guillediaaazz/FDEM_transmitter/Hardware/3d_models/ESP32-DEVKITC-32U.step

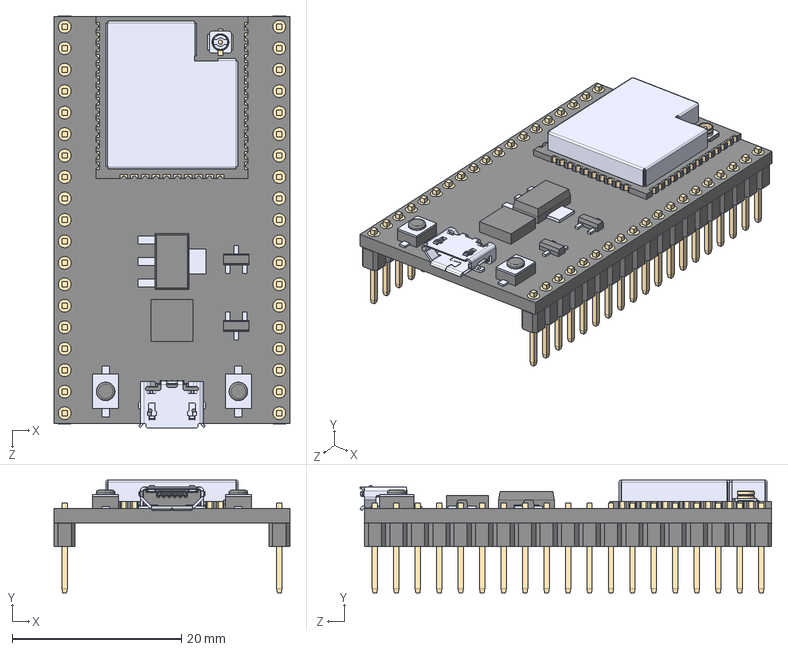
[picture p1: CAD file, 2026-08-08]
Hardware/3d_models/ESP32-DEVKITC-32U.step
27.9 x 13.4 x 48.8 mm
