guillediaaazz/FDEM_transmitter/Hardware/FDEM_tx_schematic.pdf

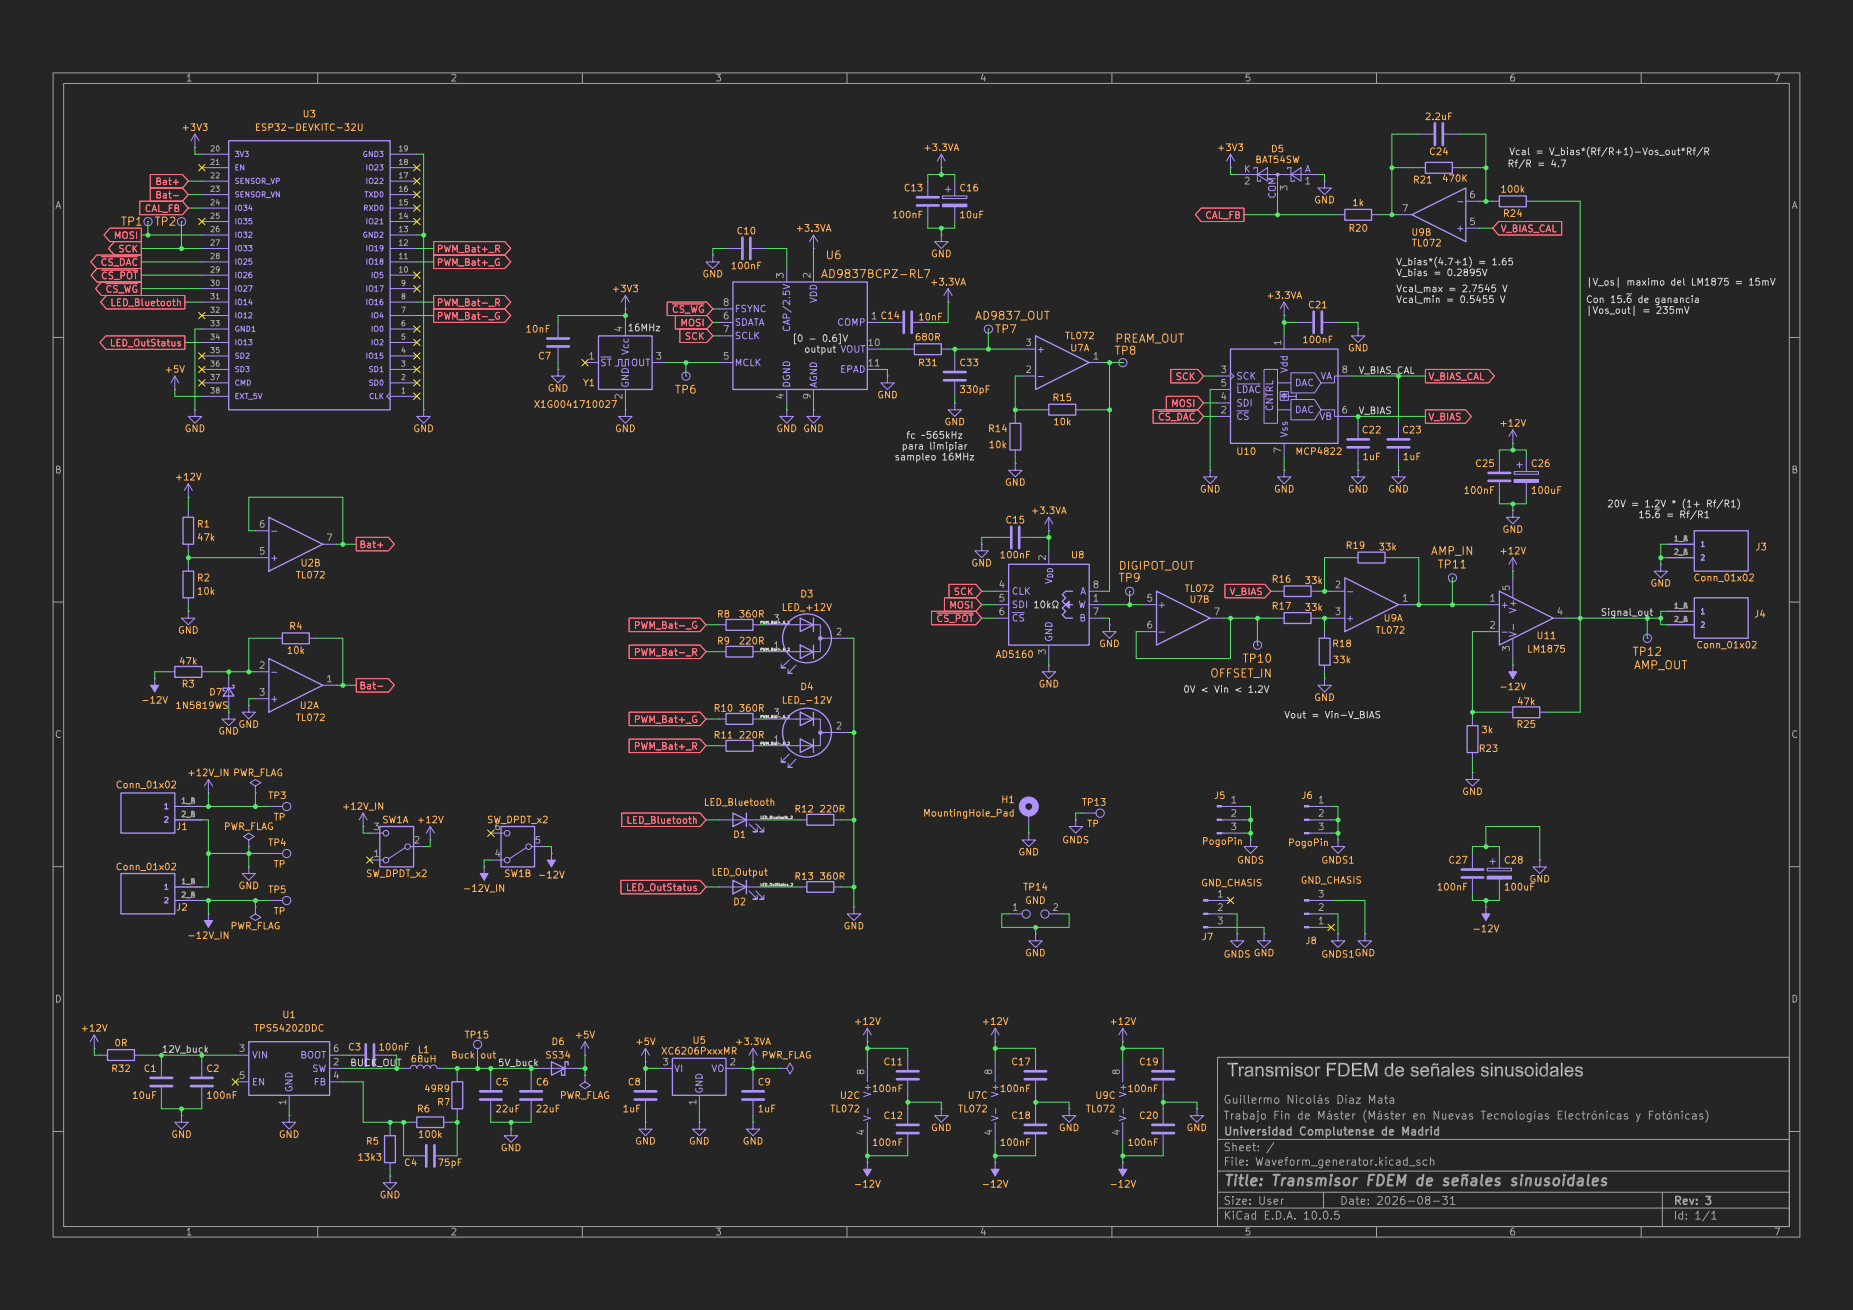
[picture p2: page 1]
