guillediaaazz/FDEM_transmitter/Hardware/FDEM_tx_schematic_rotated.pdf

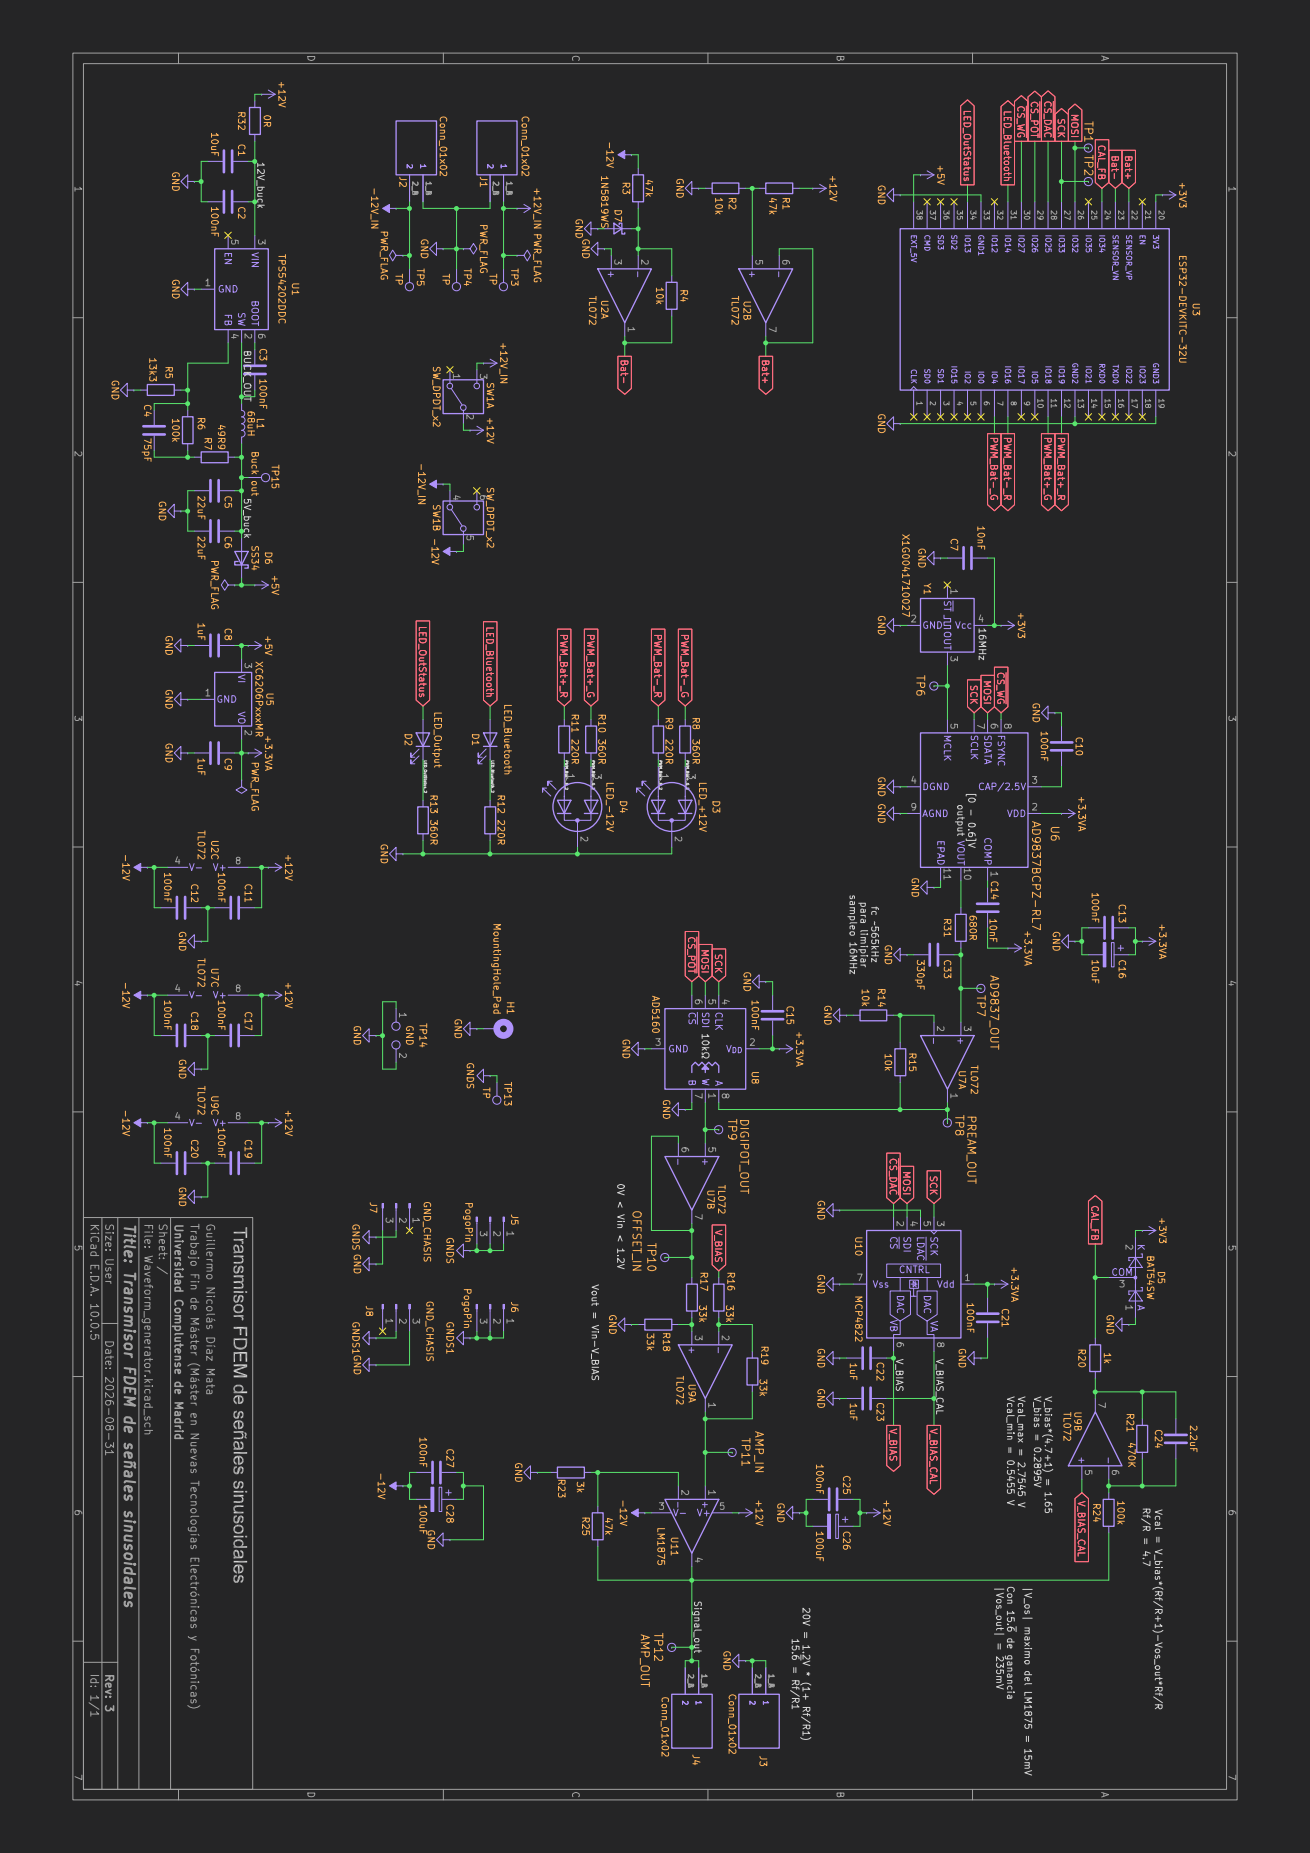
[picture p3: page 1]
