guillediaaazz/FDEM_transmitter/Hardware/FDEM_tx_schematic_rev3.pdf

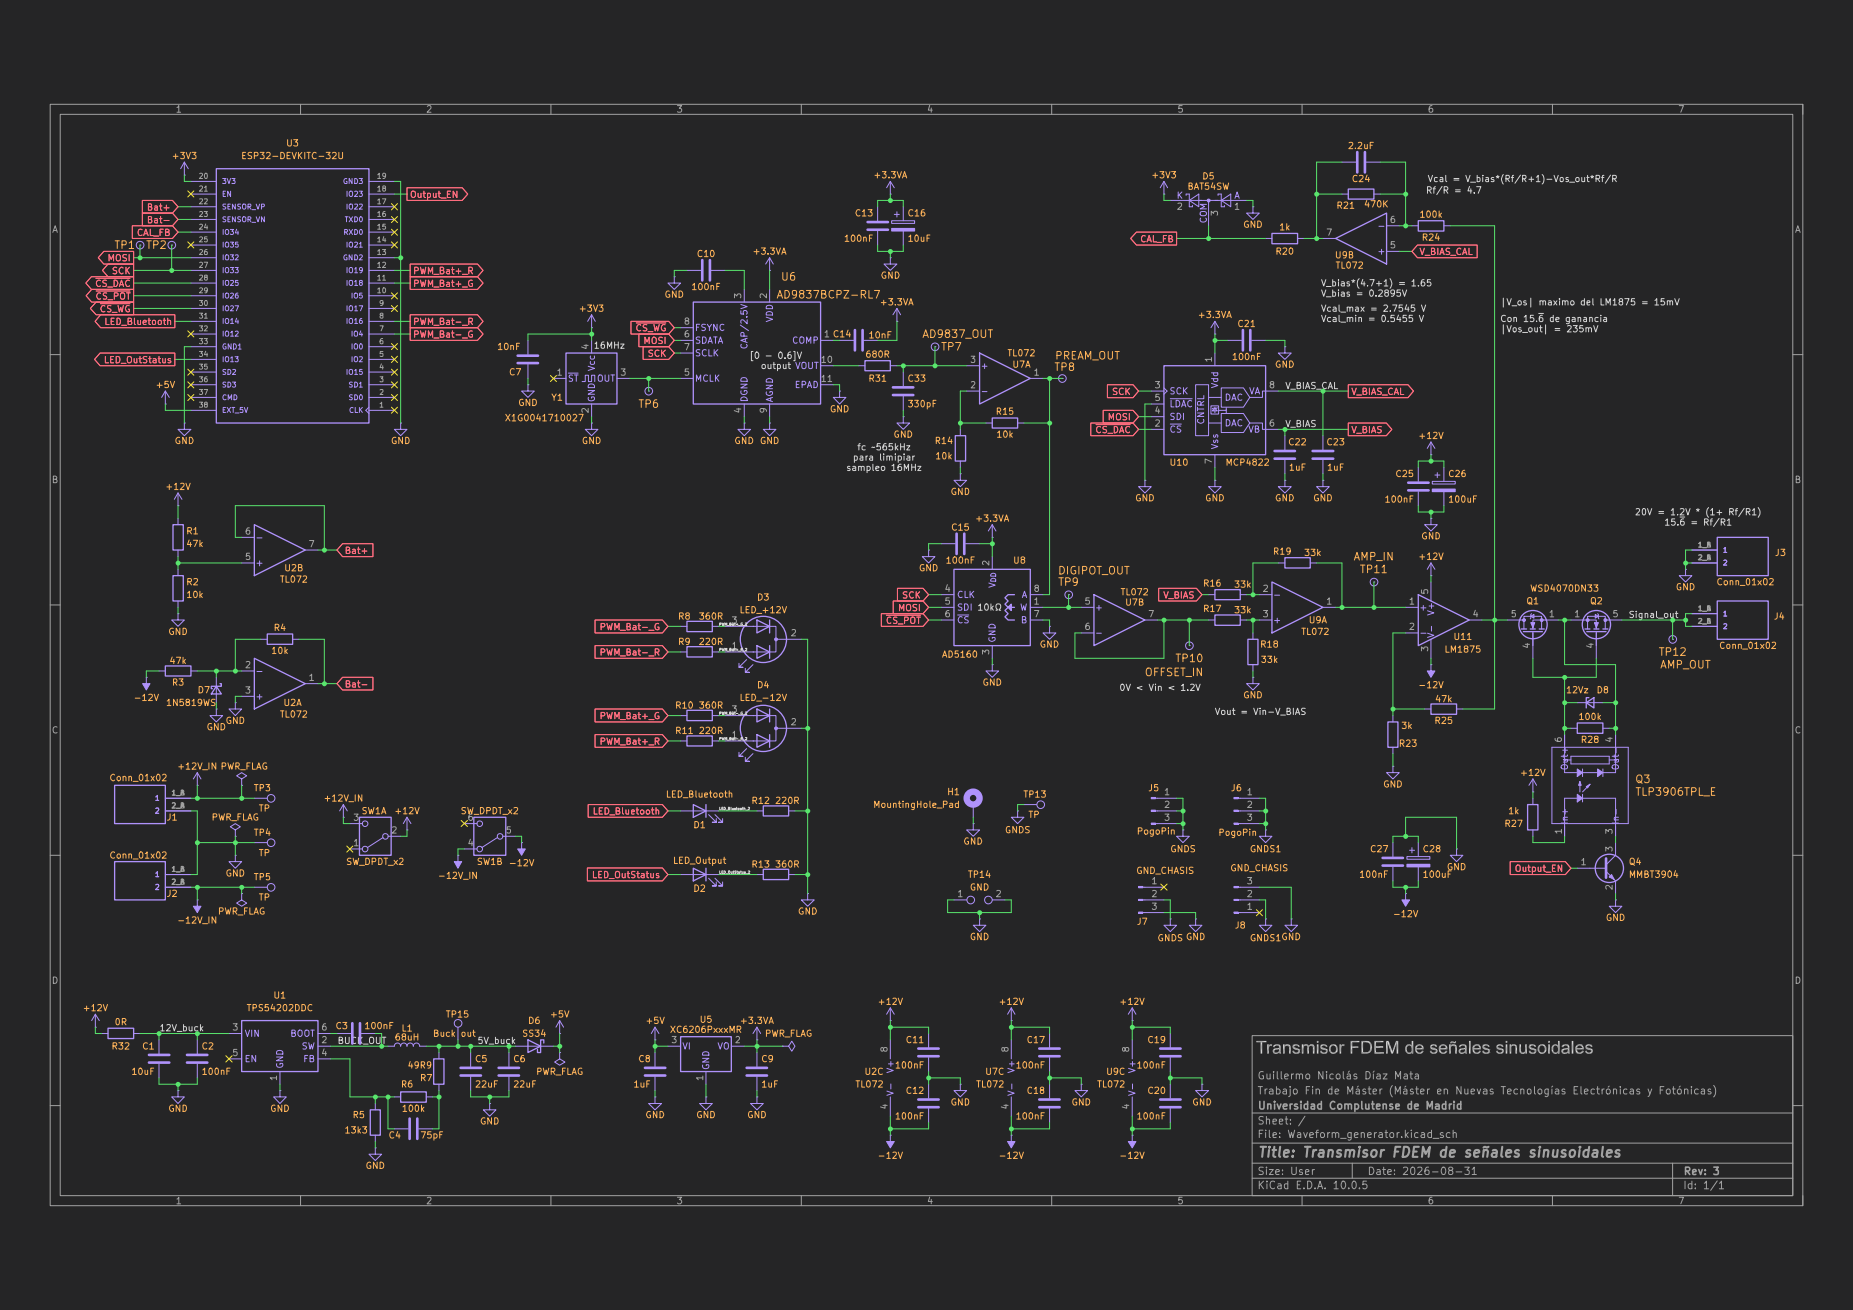
[picture p4: page 1]
