guillediaaazz/FDEM_transmitter/Hardware/Waveform_generator/Waveform_generator.kicad_pcb

## KiCad design Hardware/Waveform_generator/Waveform_generator.kicad_pcb (2026-09-06)

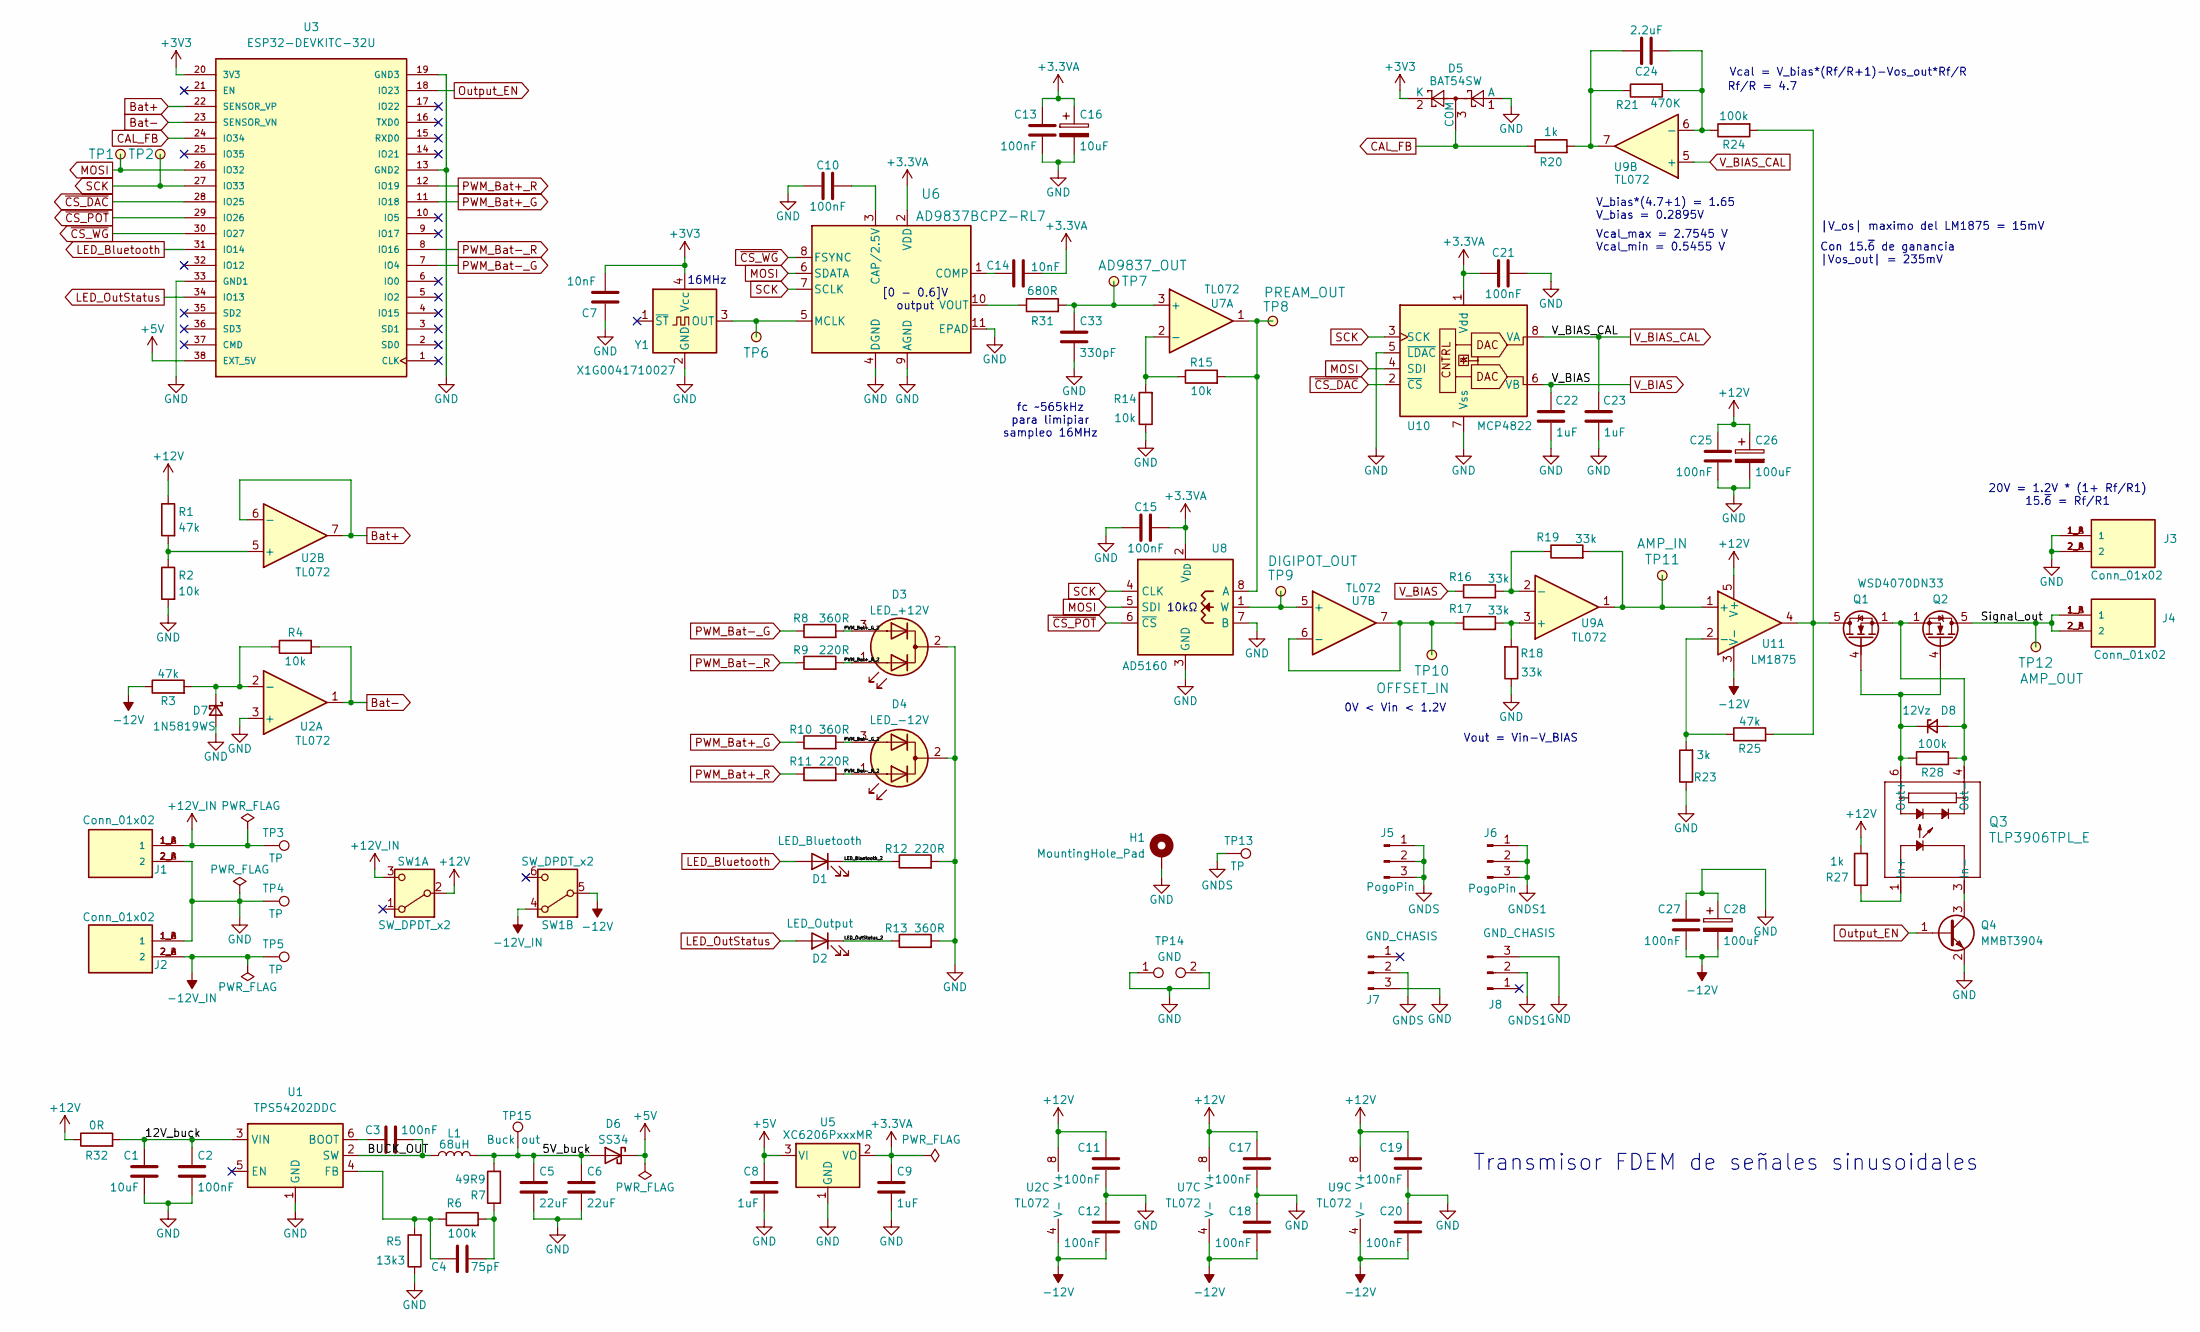
[picture p5: schematic Waveform_generator.kicad_sch, Transmisor FDEM de señales sinusoidales]

Parts:
C1: 10uF; C_0805_2012Metric_Pad1.18x1.45mm_HandSolder; LCSC C15850
C2, C3, C10, C11, C12, C13, C15, C17, C18, C19, C20, C21, C25, C27: 100nF; C_0603_1608Metric_Pad1.08x0.95mm_HandSolder; LCSC C14663
C4: 75pF; C_0402_1005Metric_Pad0.74x0.62mm_HandSolder; LCSC C107010
C5, C6: 22uF; C_0603_1608Metric_Pad1.08x0.95mm_HandSolder; LCSC C59461
C7, C14: 10nF; C_0402_1005Metric_Pad0.74x0.62mm_HandSolder; LCSC C15195
C8, C9: 1uF; C_0603_1608Metric_Pad1.08x0.95mm_HandSolder; LCSC C15849
C16: 10uF; CP_EIA-3216-18_Kemet-A_HandSolder; LCSC C7171
C22, C23: 1uF; C_0805_2012Metric_Pad1.18x1.45mm_HandSolder; LCSC C1712
C24: 2.2uF; C_0603_1608Metric_Pad1.08x0.95mm_HandSolder; LCSC C23630
C26, C28: 100uF; CP_Radial_D5.0mm_P2.00mm
C33: 330pF; C_0603_1608Metric_Pad1.08x0.95mm_HandSolder; LCSC C1664
D1: LED_Bluetooth; LED_D3.0mm_Horizontal_O1.27mm_Z2.0mm
D2: LED_Output; LED_D3.0mm_Horizontal_O1.27mm_Z2.0mm
D3: LED_+12V; LED_D3.0mm-3
D4: LED_-12V; LED_D3.0mm-3
D5: BAT54SW; SOT-323_SC-70; LCSC C22466373
D6: SS34; D_SMA; LCSC C8678
D7: 1N5819WS; D_SOD-323_HandSoldering; LCSC C191023
D8: 12Vz; D_SOD-323; LCSC C19077447
H1: MountingHole_Pad; MountingHole_3.2mm_M3_Pad_TopBottom
J1, J2, J3, J4: Conn_01x02; KF142R_2p
J5, J6: PogoPin; Pogo pin 1x3 2.54mm male horizontal
J7: GND_CHASIS; PinHeader_1x03_P2.54mm_Vertical
J8: GND_CHASIS; PinHeader_1x03_P2.54mm_Horizontal
L1: 68uH; L_Sunlord_SWPA6045S; LCSC C53663
Q1, Q2: WSD4070DN33; VSON-8_3.3x3.3mm_P0.65mm_NexFET; LCSC C719095
Q3: TLP3906TPL_E; 4pin SO6_TOS; LCSC C146278
Q4: MMBT3904; SOT-23; LCSC C20526
R1, R3, R25: 47k; R_0603_1608Metric_Pad0.98x0.95mm_HandSolder; LCSC C25819
R2, R4, R14, R15: 10k; R_0805_2012Metric_Pad1.20x1.40mm_HandSolder; LCSC C17414
R5: 13k3; R_0603_1608Metric_Pad0.98x0.95mm_HandSolder; LCSC C25952
R6, R24, R28: 100k; R_0603_1608Metric_Pad0.98x0.95mm_HandSolder; LCSC C25803
R7: 49R9; R_0805_2012Metric_Pad1.20x1.40mm_HandSolder; LCSC C17720
R8, R10, R13: 360R; R_0603_1608Metric_Pad0.98x0.95mm_HandSolder; LCSC C25194
R9, R11, R12: 220R; R_0805_2012Metric_Pad1.20x1.40mm_HandSolder; LCSC C17557
R16, R17, R18, R19: 33k; R_0603_1608Metric_Pad0.98x0.95mm_HandSolder; LCSC C4216
R20, R27: 1k; R_0603_1608Metric_Pad0.98x0.95mm_HandSolder; LCSC C21190
R21: 470K; R_0603_1608Metric_Pad0.98x0.95mm_HandSolder; LCSC C23178
R23: 3k; R_0603_1608Metric_Pad0.98x0.95mm_HandSolder; LCSC C4211
R31: 680R; R_0805_2012Metric_Pad1.20x1.40mm_HandSolder; LCSC C17798
R32: 0R; R_1206_3216Metric_Pad1.30x1.75mm_HandSolder; LCSC C17888
SW1: SW_DPDT_x2; SPDT_6P_MTS-2XX_C4_horizontal
TP1, TP2, TP6: Test Point; TestPoint_THTPad_D2.0mm_Drill1.0mm; Part Number HARWIN_S1751-46
TP3, TP4, TP5, TP13: TP; TestPoint_THTPad_D2.0mm_Drill1.0mm
TP7: AD9837_OUT; TestPoint_THTPad_D2.0mm_Drill1.0mm; Part Number HARWIN_S1751-46
TP8: PREAM_OUT; TestPoint_THTPad_D2.0mm_Drill1.0mm; Part Number HARWIN_S1751-46
TP9: DIGIPOT_OUT; TestPoint_THTPad_D2.0mm_Drill1.0mm; Part Number HARWIN_S1751-46
TP10: OFFSET_IN; TestPoint_THTPad_D2.0mm_Drill1.0mm; Part Number HARWIN_S1751-46
TP11: AMP_IN; TestPoint_THTPad_D2.0mm_Drill1.0mm; Part Number HARWIN_S1751-46
TP12: AMP_OUT; TestPoint_THTPad_D2.0mm_Drill1.0mm; Part Number HARWIN_S1751-46
TP14: GND; PinHeader_1x02_P2.54mm_Vertical
TP15: Buck out; TestPoint_THTPad_D2.0mm_Drill1.0mm
U1: TPS54202DDC; SOT-23-6; LCSC C191884
U2, U7, U9: TL072; SOIC-8_3.9x4.9mm_P1.27mm; LCSC C6961
U3: ESP32-DEVKITC-32U; ESP32_38pin; PARTREV V4
U5: XC6206PxxxMR; SOT-23-3; LCSC C5446
U6: AD9837BCPZ-RL7; 10-Lead LFCSP_WD (CP-10-9); LCSC C138562
U8: AD5160; SOT-23-8; LCSC C40097
U10: MCP4822; SOIC-8_3.9x4.9mm_P1.27mm; LCSC C16040
U11: LM1875; TO-220-5_P3.4x3.7mm_StaggerOdd_Lead3.8mm_Vertical
Y1: X1G0041710027; Oscillator_SMD_SeikoEpson_SG210-4Pin_2.5x2.0mm; LCSC C255993

Connections:
+3.3VA: C9.1, C13.1, C14.2, C15.2, C16.1, C21.1, U5.2 (VO), U6.2 (VDD), U8.2 (V_{DD}), U10.1 (Vdd)
+3V3: C7.2, D5.2 (K), U3.20 (3V3), Y1.4 (Vcc)
+5V: C8.1, D6.1 (K), U3.38 (EXT_5V), U5.3 (VI)
+12V: C11.1, C17.1, C19.1, C25.1, C26.1, R1.1, R27.2, R32.1, SW1.2 (B), U2.8 (V+), U7.8 (V+), U9.8 (V+), U11.5 (V+); also elsewhere on the board
+12V_IN: J1.1_A (1), J1.1_B (1), SW1.3 (C), TP3.1 (1_1)
-12V: C12.2, C18.2, C20.2, C27.2, C28.2, R3.1, SW1.5 (B), U2.4 (V-), U7.4 (V-), U9.4 (V-), U11.3 (V-)
-12V_IN: J2.2_A (2), J2.2_B (2), SW1.4 (A), TP5.1 (1_1)
/5V_buck: C5.1, C6.1, D6.2 (A), L1.2, R7.2, TP15.1 (1_1); also elsewhere on the board
/12V_buck: C1.1, C2.1, R32.2, U1.3 (VIN)
/BUCK_OUT: C3.1, L1.1, U1.2 (SW)
/LED_Bluetooth_2: D1.1 (K), R12.1
/LED_OutStatus_2: D2.1 (K), R13.1
/PWM_Bat+_G_2: D3.3 (A2), R8.2
/PWM_Bat+_R_2: D3.1 (A1), R9.2
/PWM_Bat-_G_2: D4.3 (A2), R10.2
/PWM_Bat-_R_2: D4.1 (A1), R11.2
/Signal_out: J4.1_A (1), J4.1_B (1), J4.2_A (2), J4.2_B (2), Q2.5 (D), TP12.1 (1_1)
Bat+: U2.6 (-), U2.7, U3.22 (SENSOR_VP)
Bat-: R4.2, U2.1, U3.23 (SENSOR_VN)
CAL_FB: D5.3 (COM), R20.1, U3.24 (IO34)
GND: C1.2, C2.2, C5.2, C6.2, C7.1, C8.2, C9.2, C10.1, C11.2, C12.1, C13.2, C15.1, C16.2, C17.2, C18.1, C19.2, C20.1, C21.2, C22.1, C23.1, C25.2, C26.2, C27.1, C28.1, C33.2, D3.2 (K), D4.2 (K), D5.1 (A), D7.2 (A), H1.1 (1_1), J1.2_A (2), J1.2_B (2), J2.1_A (1), J2.1_B (1), J3.1_A (1), J3.1_B (1), J3.2_A (2), J3.2_B (2), J7.3, J8.3, Q4.2 (E), R2.2, R5.1, R12.2, R13.2, R14.1, R18.1, R23.1, TP4.1 (1_1), TP14.1, TP14.2, U1.1 (GND), U2.3 (+), U3.13 (GND2), U3.19 (GND3), U3.33 (GND1), U5.1 (GND), U6.4 (DGND), U6.9 (AGND), U6.11 (EPAD), U8.3 (GND), U8.7 (B), U10.5 (~LDAC), U10.7 (Vss), Y1.2 (GND); also elsewhere on the board
GNDS: J5.1, J5.2, J5.3, J7.2, TP13.1 (1_1)
GNDS1: J6.1, J6.2, J6.3, J8.2
LED_Bluetooth: D1.2 (A), U3.31 (IO14)
LED_OutStatus: D2.2 (A), U3.34 (IO13)
MOSI: TP1.1 (1_1), U3.26 (IO32), U6.6 (SDATA), U8.5 (SDI), U10.4 (SDI)
unnamed: C4.2, R6.2, R7.1
unnamed: C24.1, R20.2, R21.1, U9.7
unnamed: D7.1 (K), R3.2, R4.1, U2.2 (-)
unnamed: D8.1 (K), Q1.4 (G), Q2.4 (G), Q3.6 (Out+), R28.1
unnamed: D8.2 (A), Q1.1 (S), Q1.2 (S), Q1.3 (S), Q2.1 (S), Q2.2 (S), Q2.3 (S), Q3.4 (Out-), R28.2
unnamed 31: Q1.5 (D), R24.2, R25.2, U11.4; also elsewhere on the board
unnamed: Q3.1 (In+), R27.1
unnamed: Q3.3 (In-), Q4.3 (C)
unnamed: C3.2, U1.6 (BOOT)
unnamed: C4.1, R5.2, R6.1, U1.4 (FB)
unnamed: R1.2, R2.1, U2.5 (+)
unnamed: C10.2, U6.3 (CAP/2.5V)
unnamed: C14.1, U6.1 (COMP)
unnamed: TP6.1 (1_1), U6.5 (MCLK), Y1.3 (OUT)
unnamed: R31.1, U6.10 (VOUT)
unnamed: C33.1, R31.2, TP7.1 (1_1), U7.3 (+)
unnamed: R14.2, R15.1, U7.2 (-)
unnamed: TP9.1 (1_1), U7.5 (+), U8.1 (W)
unnamed: R17.1, TP10.1 (1_1), U7.6 (-), U7.7
unnamed: R15.2, TP8.1 (1_1), U7.1, U8.8 (A)
unnamed: R17.2, R18.2, U9.3 (+)
unnamed: R16.2, R19.1, U9.2 (-)
unnamed: C24.2, R21.2, R24.1, U9.6 (-)
unnamed: R19.2, TP11.1 (1_1), U9.1, U11.1 (+)
unnamed 50: R23.2, R25.1, U11.2 (-); also elsewhere on the board
Output_EN: Q4.1 (B), U3.18 (IO23)
PWM_Bat+_G: R10.1, U3.11 (IO18)
PWM_Bat+_R: R11.1, U3.12 (IO19)
PWM_Bat-_G: R8.1, U3.7 (IO4)
PWM_Bat-_R: R9.1, U3.8 (IO16)
SCK: TP2.1 (1_1), U3.27 (IO33), U6.7 (SCLK), U8.4 (CLK), U10.3 (SCK)
V_BIAS: C22.2, R16.1, U10.6 (VB)
V_BIAS_CAL: C23.2, U9.5 (+), U10.8 (VA)
~CS_DAC: U3.28 (IO25), U10.2 (~CS)
~CS_POT: U3.29 (IO26), U8.6 (~CS)
~CS_WG: U3.30 (IO27), U6.8 (FSYNC)

Notes on the sheet:
0V < Vin < 1.2V
Vcal = V_bias*(Rf/R+1)-Vos_out*Rf/R
|V_os| maximo del LM1875 = 15mV
10kΩ
Transmisor FDEM de señales sinusoidales
Rf/R = 4.7
Vout = Vin-V_BIAS
[0 - 0.6]V output
V_bias*(4.7+1) = 1.65 V_bias = 0.2895V
Con 15.~{6} de ganancia |Vos_out| = 235mV
20V = 1.2V * (1+ Rf/R1) 15.~{6} = Rf/R1
16MHz
fc ~565kHz para limipiar sampleo 16MHz
Vcal_max = 2.7545 V Vcal_min = 0.5455 V

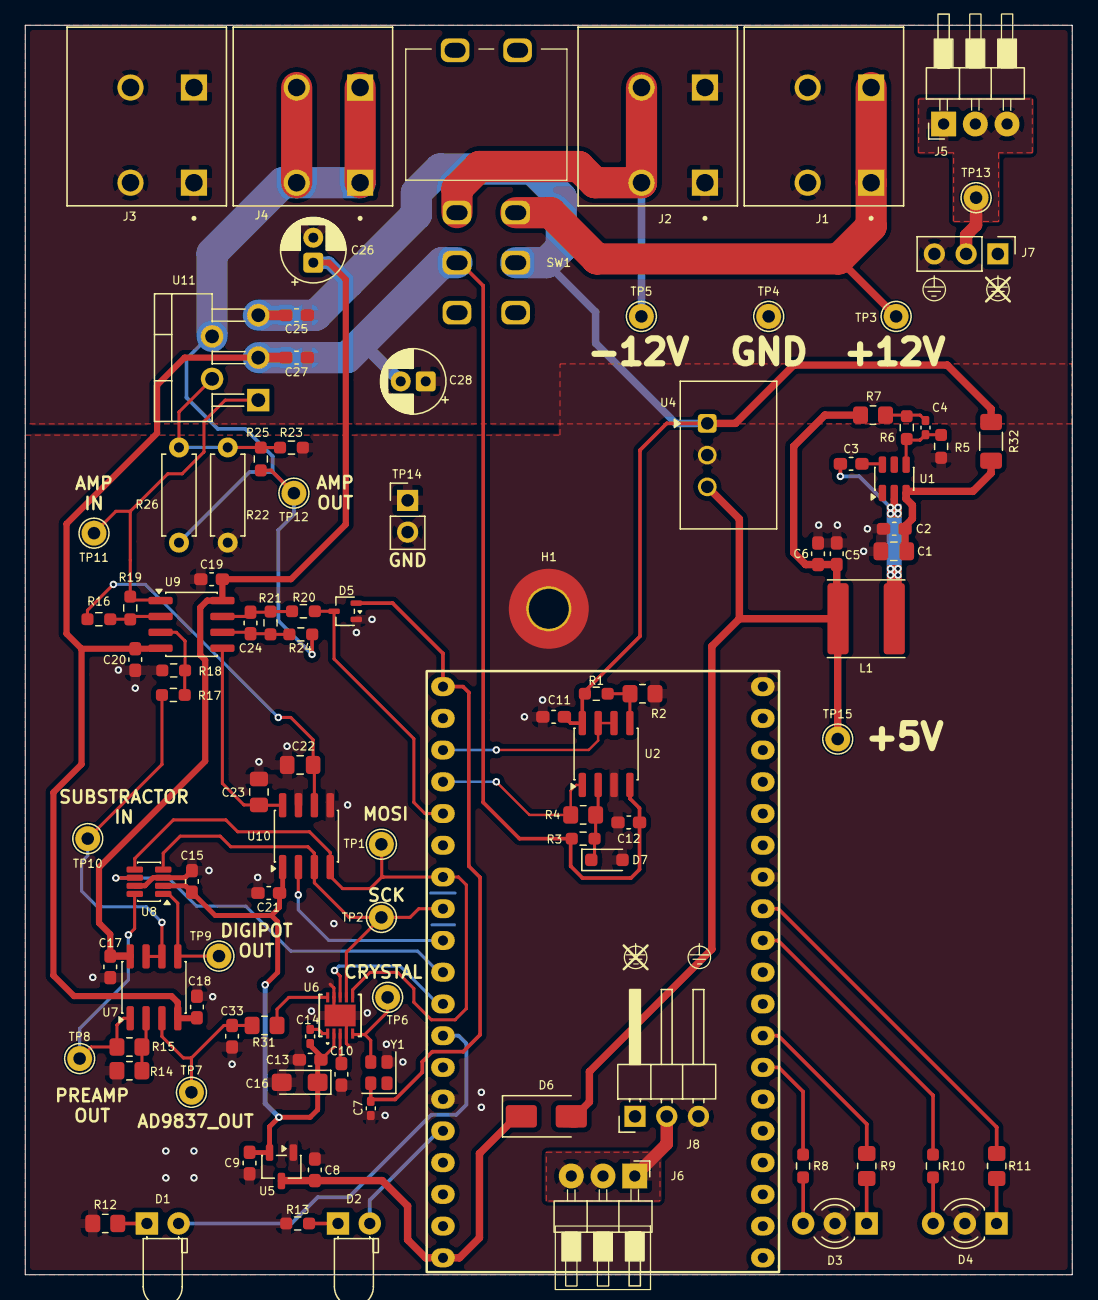
[picture p6: board Waveform_generator.kicad_pcb from above]

Board: 2 copper layers, 83.8 x 100.0 mm, 102 parts (0 on the bottom side), 57 nets.

Other parts of the board:
R22: 3k; R_Axial_DIN0207_L6.3mm_D2.5mm_P7.62mm_Horizontal
R26: 47k; R_Axial_DIN0207_L6.3mm_D2.5mm_P7.62mm_Horizontal
U4: TSR1-2450E; Converter_DCDC_TRACO_TSR1-xxxxE_THT

Their connections:
+12V: U4.1 (Vin); also elsewhere on the board
/5V_buck: U4.3 (Vout); also elsewhere on the board
GND: R22.1, U4.2 (GND); also elsewhere on the board
unnamed 31: R26.2; also elsewhere on the board
unnamed 50: R22.2, R26.1; also elsewhere on the board
