guillediaaazz/FDEM_transmitter/Hardware/Waveform_generator_faceplates/Waveform_generator_faceplates.kicad_pcb

## KiCad design Hardware/Waveform_generator_faceplates/Waveform_generator_faceplates.kicad_pcb (2026-09-06)

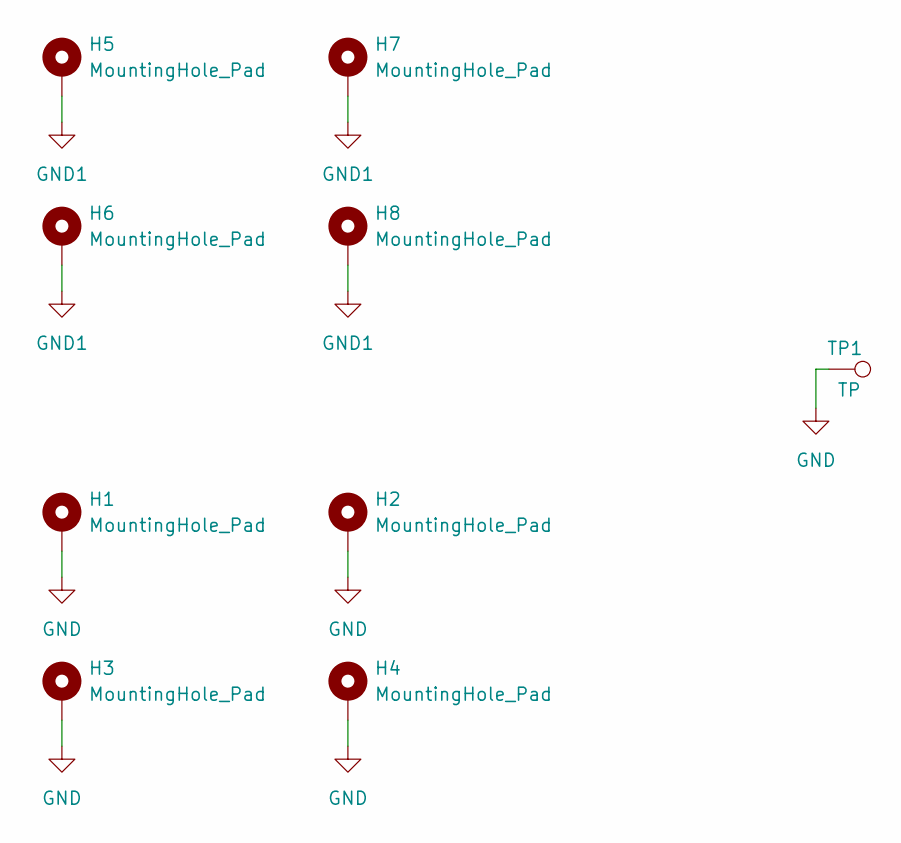
[picture p7: schematic Waveform_generator_faceplates.kicad_sch]

Parts:
H1, H2, H3, H4, H5, H6, H7, H8: MountingHole_Pad; M3 hole (3.2mm hole Pad 5mm)
TP1: TP; TestPoint_THTPad_D2.0mm_Drill1.0mm

Connections:
GND: H1.1 (1_1), H2.1 (1_1), H3.1 (1_1), H4.1 (1_1), TP1.1 (1_1)
GND1: H5.1 (1_1), H6.1 (1_1), H7.1 (1_1), H8.1 (1_1)

Board: 2 copper layers, 9 parts (0 on the bottom side), 2 nets, no tracks yet.
