guillediaaazz/FDEM_transmitter/(commit log)

2026-08-08 Reorganizado el directorio
    [Emmiter-c.kicad_pcb, Emmiter-c.kicad_sch]
2026-08-08 Creados archivos necesarios para que la interfaz web pueda funcionar offline
2026-08-08 Renombrada carpeta de UI
2026-08-08 Actualización de UI y componentes DAC y generador DDS
2026-08-09 Eliminados algunos datasheets y cambiado el workspace
2026-08-09 Primer try de firmware y retocado la UI web
2026-08-09 Rellenado archivo Config y desarrollada la UI web
    [Waveform_generator.kicad_sch]
2026-08-17 Revisión 1 del hardware. Reorganizaco un poco el layout y añadidos shottky de protección, puente para desconectar el buck, conectores de pogo para conectar a masa la carcasa de aluminio, agrandado el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
    Actualizado el controlador para que por USB no printee la batería todo el rato.
    Añadida opción de reseteo del AD9837 en cada comando para probar si se soluciona el problema (no genera nada a la salida)
    [Waveform_generator.kicad_pcb, Waveform_generator.kicad_sch, Waveform_generator_faceplates.kicad_pcb, Waveform_generator_faceplates.kicad_sch, bom.csv, designators.csv, positions.csv]
2026-08-18 Rev 2 de hardware actualizada con error en los pines del ad9837 (SCLK y CS intercambiados). ERROR IDENTIFICADO
    Añadida corrección del offset que hay a la salida del ad9837 que antes no se tenía en cuenta.
    [Waveform_generator.kicad_pcb, Waveform_generator.kicad_sch, Waveform_generator_faceplates.kicad_pcb, bom.csv, designators.csv, positions.csv]
2026-08-20 Actualización de firmware y software
    [Waveform_generator.kicad_sch]
2026-08-21 Nueva versión. Ajuste del proceso de calibración del offset.
2026-08-22 Ajustado el UI para invertir el slider de calibración manual (más intuitivo) y añadir botones de incremento decremento por pasos.
2026-08-29 Ajustes en la configuración y mejoras en la gestión de comunicaciones BLE, incluyendo el manejo de notificaciones y la terminación de mensajes. Actualización de la versión de los activos en el HTML y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
2026-08-31 Añadido switch para el output en el esquemático
    [Waveform_generator.kicad_pcb, Waveform_generator.kicad_sch]
2026-08-31 Arreglado problema de no linealidad en el offset a lo largo del rango de amplitud. Ahora, ajustando el offset manualmente se puede llegar hasta un error de unos pocos mV de offset a la salida. Se ha 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
    [CommandProtocol.h, Config.h, OffsetGainMath.h, PowerMonitor.cpp, PowerMonitor.h, WaveEngine.cpp, WaveEngine.h, main.cpp]
2026-08-31 Pequeña corrección del ofset en el punto 0. Anteriormente se itrodujo un ajuste para este punto, pero ahora que la amplitud se calcula de forma precisa ya no era necesario y estaba causando un offset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
2026-09-01 Comenzado a desarrollar el GUI de control standalone en Python
2026-09-06 Actualización esquemático
    [Waveform_generator.kicad_pcb, Waveform_generator.kicad_sch, Waveform_generator_faceplates.kicad_pcb]
2026-09-15 pequeños cambios
    [Waveform_generator.kicad_sch]
